Erzerum/split-flap-pcb/pcb/splitflappcb.step

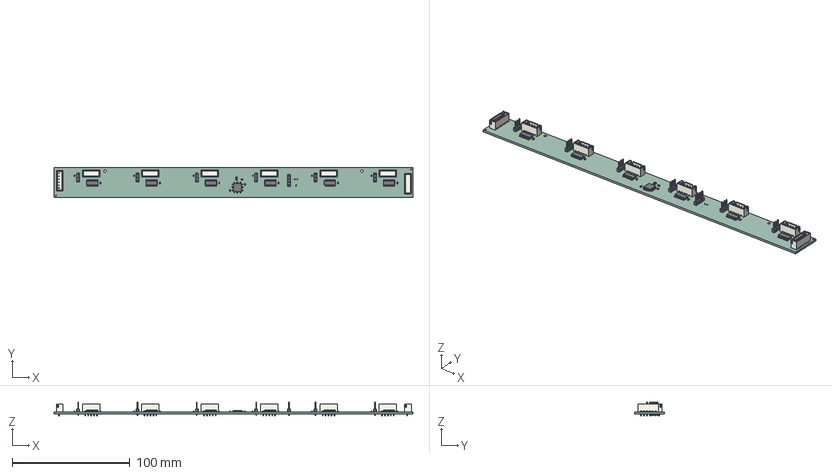
[picture p1: CAD file, 2024-07-14]
pcb/splitflappcb.step
304.8 x 25.4 x 11.9 mm
JST_B5B_XH_A x 6
PinHeader_1x03_P254mm_Vertical x 6
C_0603_1608Metric x 17
LQFP_48_7x7mm_P05mm
SOIC_16_39x99mm_P127mm x 6
JST_B6B_XH_A x 2
PinHeader_1x04_P254mm_Vertical
_autosave-splitflappcb_PCB
