Erzerum/split-flap-pcb/pcb/splitflappcb.kicad_pcb

## KiCad design pcb/splitflappcb.kicad_pcb (2024-08-31)

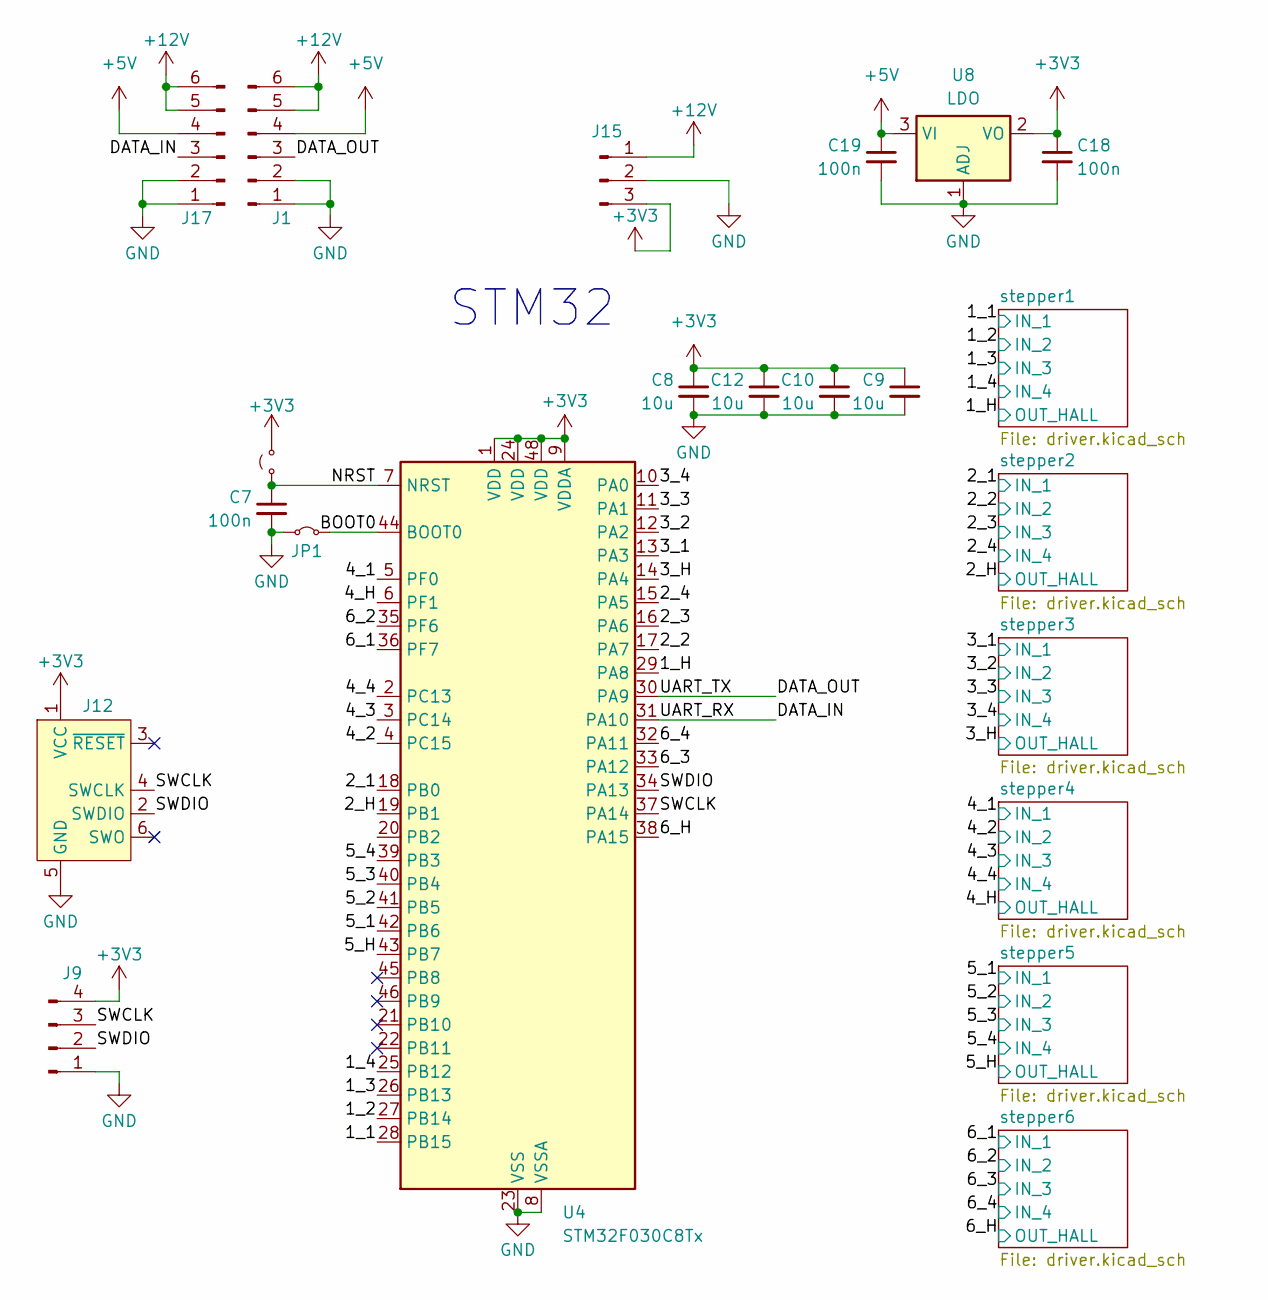
[picture p2: schematic splitflappcb.kicad_sch]

Parts:
C7, C18, C19: 100n; C_0603_1608Metric; LCSC C14663
C8, C9, C10, C12: 10u; C_0603_1608Metric; LCSC C19702
J1, J17: Conn_01x04_Pin; JST_XH_B6B-XH-AM_1x06_P2.50mm_Vertical; LCSC C161873
J9: Conn_01x04_Pin; PinHeader_1x04_P2.54mm_Vertical; LCSC C6332197
J12: Conn_ARM_SWD_TagConnect_TC2030-NL; Tag-Connect_TC2030-IDC-NL_2x03_P1.27mm_Vertical
J15: SOT-89-3; LCSC C351450
JP1: Jumper_2_Small_Bridged; SolderJumper-2_P1.3mm_Bridged_RoundedPad1.0x1.5mm
JP2: Jumper_2_Small_Open; SolderJumper-2_P1.3mm_Open_RoundedPad1.0x1.5mm
U4: STM32F030C8Tx; LQFP-48_7x7mm_P0.5mm; LCSC C62514
U8: LDO; SOT-23-3; LCSC C5446

Connections:
+3V3: C8.1, C9.1, C10.1, C12.1, C18.1, J9.4, J12.1 (VCC), J15.3, JP2.2 (B), U4.1 (VDD), U4.9 (VDDA), U4.24 (VDD), U4.48 (VDD), U8.2 (VO)
+5V: C19.1, J1.4, J17.4, U8.3 (VI); also elsewhere on the board
+12V: J1.5, J1.6, J15.1, J17.5, J17.6; also elsewhere on the board
/1_1: U4.28 (PB15); also elsewhere on the board
/1_2: U4.27 (PB14); also elsewhere on the board
/1_3: U4.26 (PB13); also elsewhere on the board
/1_4: U4.25 (PB12); also elsewhere on the board
/1_H: U4.29 (PA8); also elsewhere on the board
/2_1: U4.18 (PB0); also elsewhere on the board
/2_2: U4.17 (PA7); also elsewhere on the board
/2_3: U4.16 (PA6); also elsewhere on the board
/2_4: U4.15 (PA5); also elsewhere on the board
/2_H: U4.19 (PB1); also elsewhere on the board
/3_1: U4.13 (PA3); also elsewhere on the board
/3_2: U4.12 (PA2); also elsewhere on the board
/3_3: U4.11 (PA1); also elsewhere on the board
/3_4: U4.10 (PA0); also elsewhere on the board
/3_H: U4.14 (PA4); also elsewhere on the board
/4_1: U4.5 (PF0); also elsewhere on the board
/4_2: U4.4 (PC15); also elsewhere on the board
/4_3: U4.3 (PC14); also elsewhere on the board
/4_4: U4.2 (PC13); also elsewhere on the board
/4_H: U4.6 (PF1); also elsewhere on the board
/5_1: U4.42 (PB6); also elsewhere on the board
/5_2: U4.41 (PB5); also elsewhere on the board
/5_3: U4.40 (PB4); also elsewhere on the board
/5_4: U4.39 (PB3); also elsewhere on the board
/5_H: U4.43 (PB7); also elsewhere on the board
/6_1: U4.36 (PF7); also elsewhere on the board
/6_2: U4.35 (PF6); also elsewhere on the board
/6_3: U4.33 (PA12); also elsewhere on the board
/6_4: U4.32 (PA11); also elsewhere on the board
/6_H: U4.38 (PA15); also elsewhere on the board
/BOOT0: JP1.1 (A), U4.44 (BOOT0)
/DATA_IN: J17.3, U4.31 (PA10)
/DATA_OUT: J1.3, U4.30 (PA9)
/NRST: C7.1, JP2.1 (A), U4.7 (NRST)
/SWCLK: J9.3, J12.4 (SWCLK), U4.37 (PA14)
/SWDIO: J9.2, J12.2 (SWDIO), U4.34 (PA13)
GND: C7.2, C8.2, C9.2, C10.2, C12.2, C18.2, C19.2, J1.1, J1.2, J9.1, J12.5 (GND), J15.2, J17.1, J17.2, JP1.2 (B), U4.8 (VSSA), U4.23 (VSS), U4.47 (VSS), U8.1 (ADJ); also elsewhere on the board

Notes on the sheet:
STM32

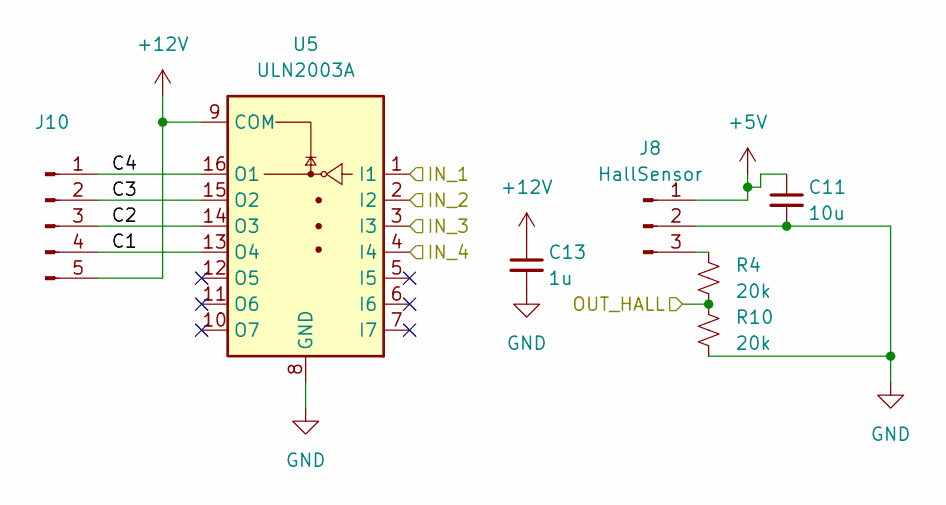
[picture p3: schematic driver.kicad_sch]

Parts:
C11: 10u; C_0603_1608Metric; LCSC C19702
C13: 1u; C_0603_1608Metric; LCSC C15849
J8: HallSensor; PinHeader_1x03_P2.54mm_Vertical; LCSC C6332196
J10: Conn_01x05_Pin; JST_XH_B5B-XH-AM_1x05_P2.50mm_Vertical; LCSC C161872
R4, R10: 20k; R_0805_2012Metric; LCSC C4328
U5: ULN2003A; SOIC-16_3.9x9.9mm_P1.27mm; LCSC C7512

Connections:
+5V: C11.1, J8.1; also elsewhere on the board
+12V: C13.1, J10.5, U5.9 (COM); also elsewhere on the board
/4_1: U5.1 (I1); also elsewhere on the board
/4_2: U5.2 (I2); also elsewhere on the board
/4_3: U5.3 (I3); also elsewhere on the board
/4_4: U5.4 (I4); also elsewhere on the board
/4_H: R4.2, R10.1; also elsewhere on the board
/stepper4/C1: J10.4, U5.13 (O4)
/stepper4/C2: J10.3, U5.14 (O3)
/stepper4/C3: J10.2, U5.15 (O2)
/stepper4/C4: J10.1, U5.16 (O1)
GND: C11.2, C13.2, J8.2, R10.2, U5.8 (GND); also elsewhere on the board
unnamed: J8.3, R4.1

Parts of its further copies:
C1, C3, C5, C14, C16: 10u; C_0603_1608Metric; LCSC C19702
C2, C4, C6, C15, C17: 1u; C_0603_1608Metric; LCSC C15849
J2, J5, J6, J11, J14: HallSensor; PinHeader_1x03_P2.54mm_Vertical; LCSC C6332196
J3, J4, J7, J13, J16: Conn_01x05_Pin; JST_XH_B5B-XH-AM_1x05_P2.50mm_Vertical; LCSC C161872
R1, R2, R3, R5, R6, R7, R8, R9, R11, R12: 20k; R_0805_2012Metric; LCSC C4328
U1, U2, U3, U6, U7: ULN2003A; SOIC-16_3.9x9.9mm_P1.27mm; LCSC C7512

Connections of its further copies:
+5V: C1.1, C3.1, C5.1, C14.1, C16.1, J2.1, J5.1, J6.1, J11.1, J14.1; also elsewhere on the board
+12V: C2.1, C4.1, C6.1, C15.1, C17.1, J3.5, J4.5, J7.5, J13.5, J16.5, U1.9 (COM), U2.9 (COM), U3.9 (COM), U6.9 (COM), U7.9 (COM); also elsewhere on the board
/1_1: U1.1 (I1); also elsewhere on the board
/1_2: U1.2 (I2); also elsewhere on the board
/1_3: U1.3 (I3); also elsewhere on the board
/1_4: U1.4 (I4); also elsewhere on the board
/1_H: R1.2, R7.1; also elsewhere on the board
/2_1: U2.1 (I1); also elsewhere on the board
/2_2: U2.2 (I2); also elsewhere on the board
/2_3: U2.3 (I3); also elsewhere on the board
/2_4: U2.4 (I4); also elsewhere on the board
/2_H: R2.2, R8.1; also elsewhere on the board
/3_1: U3.1 (I1); also elsewhere on the board
/3_2: U3.2 (I2); also elsewhere on the board
/3_3: U3.3 (I3); also elsewhere on the board
/3_4: U3.4 (I4); also elsewhere on the board
/3_H: R3.2, R9.1; also elsewhere on the board
/5_1: U6.1 (I1); also elsewhere on the board
/5_2: U6.2 (I2); also elsewhere on the board
/5_3: U6.3 (I3); also elsewhere on the board
/5_4: U6.4 (I4); also elsewhere on the board
/5_H: R5.2, R11.1; also elsewhere on the board
/6_1: U7.1 (I1); also elsewhere on the board
/6_2: U7.2 (I2); also elsewhere on the board
/6_3: U7.3 (I3); also elsewhere on the board
/6_4: U7.4 (I4); also elsewhere on the board
/6_H: R6.2, R12.1; also elsewhere on the board
/stepper1/C1: J3.4, U1.13 (O4)
/stepper1/C2: J3.3, U1.14 (O3)
/stepper1/C3: J3.2, U1.15 (O2)
/stepper1/C4: J3.1, U1.16 (O1)
/stepper2/C1: J4.4, U2.13 (O4)
/stepper2/C2: J4.3, U2.14 (O3)
/stepper2/C3: J4.2, U2.15 (O2)
/stepper2/C4: J4.1, U2.16 (O1)
/stepper3/C1: J7.4, U3.13 (O4)
/stepper3/C2: J7.3, U3.14 (O3)
/stepper3/C3: J7.2, U3.15 (O2)
/stepper3/C4: J7.1, U3.16 (O1)
/stepper5/C1: J13.4, U6.13 (O4)
/stepper5/C2: J13.3, U6.14 (O3)
/stepper5/C3: J13.2, U6.15 (O2)
/stepper5/C4: J13.1, U6.16 (O1)
/stepper6/C1: J16.4, U7.13 (O4)
/stepper6/C2: J16.3, U7.14 (O3)
/stepper6/C3: J16.2, U7.15 (O2)
/stepper6/C4: J16.1, U7.16 (O1)
GND: C1.2, C2.2, C3.2, C4.2, C5.2, C6.2, C14.2, C15.2, C16.2, C17.2, J2.2, J5.2, J6.2, J11.2, J14.2, R7.2, R8.2, R9.2, R11.2, R12.2, U1.8 (GND), U2.8 (GND), U3.8 (GND), U6.8 (GND), U7.8 (GND); also elsewhere on the board
unnamed: J2.3, R1.1
unnamed: J5.3, R2.1
unnamed: J6.3, R3.1
unnamed: J11.3, R5.1
unnamed: J14.3, R6.1

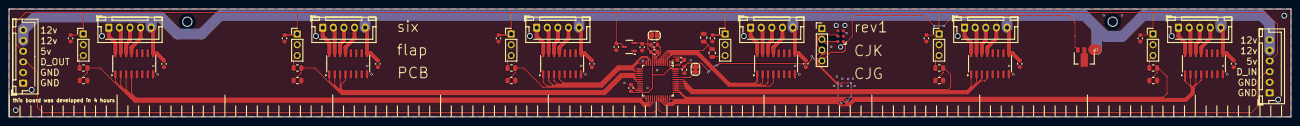
[picture p4: board splitflappcb.kicad_pcb from above]

Board: 2 copper layers, 302.0 x 25.4 mm, 58 parts (0 on the bottom side), 70 nets.
