Erzerum/split-flap-pcb/(commit log)

2024-05-23 how many attempts does it take
    me when i try to use git
    [splitflappcb.kicad_pcb]
2024-05-27 Changed out a tantalum capacitor for four better ones
    [splitflappcb.kicad_pcb, splitflappcb.kicad_sch]
2024-05-27 Fixed several drc errors
    also slightly adjusted some of the silkscreen
    [splitflappcb.kicad_pcb]
2024-07-14 ordered rev1
    [bom.csv, designators.csv, driver.kicad_sch, positions.csv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]
2024-07-21 moved everything into PCB folder
    [bom.csv, designators.csv, driver.kicad_sch, positions.csv, splitflappcb.kicad_pcb, splitflappcb.kicad_sch, splitflappcb.step]
2024-07-21 code spins all the motors, changed pcb to black
    [splitflappcb.kicad_pcb]
2024-07-25 acceleration sorta
    [stm32f03.cfg]
2024-08-31 S E N T
    [bom.csv, designators.csv, driver.kicad_sch, positions.csv, splitflappcb.kicad_pcb, splitflappcb.kicad_sch]
2024-08-31 ordered ol
    [bom.csv, driver.kicad_sch, splitflappcb.kicad_pcb, splitflappcb.kicad_sch]
